Mehmet-Emre-Dogan/smartHome/APP/sourceCode/stratchBackend.png

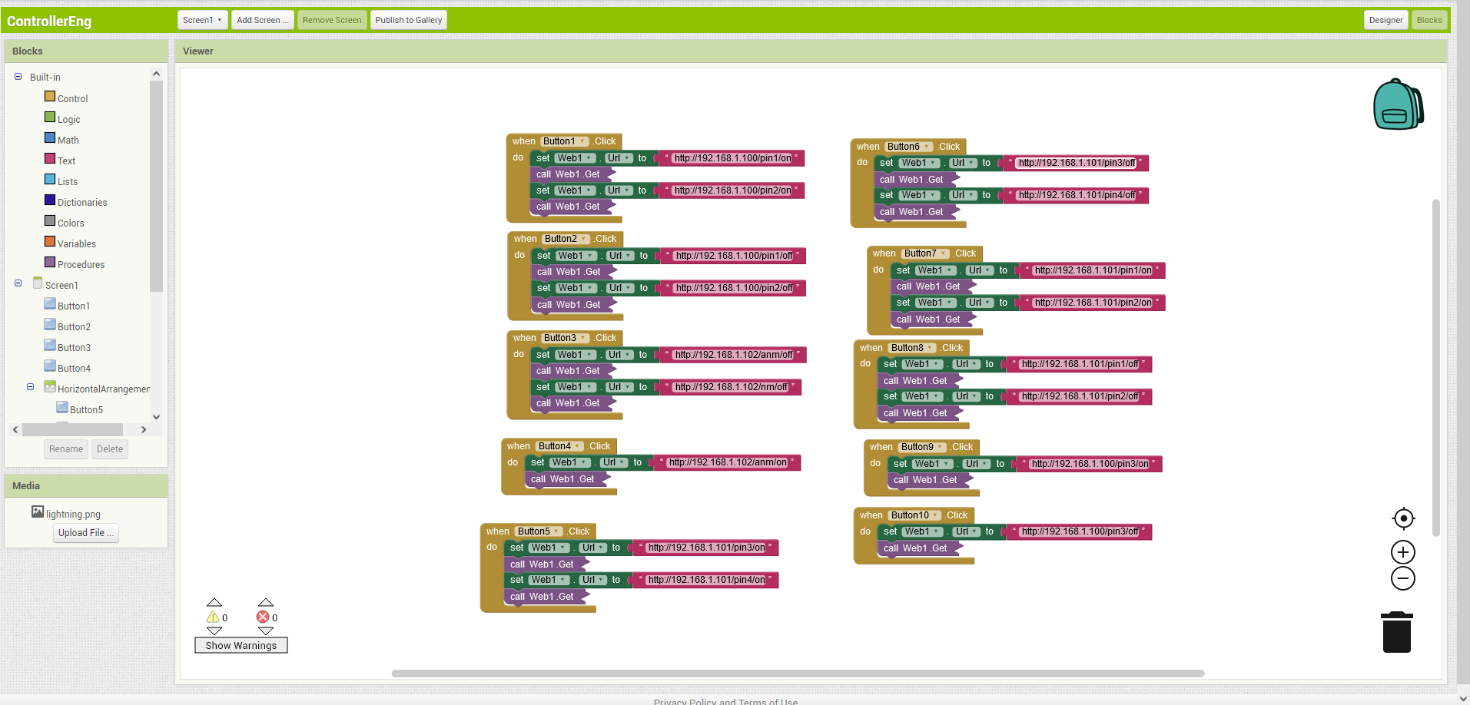
APP/sourceCode/stratchBackend.png
