Mehmet-Emre-Dogan/smartHome/APP/sourceCode/stratchFrontend.png

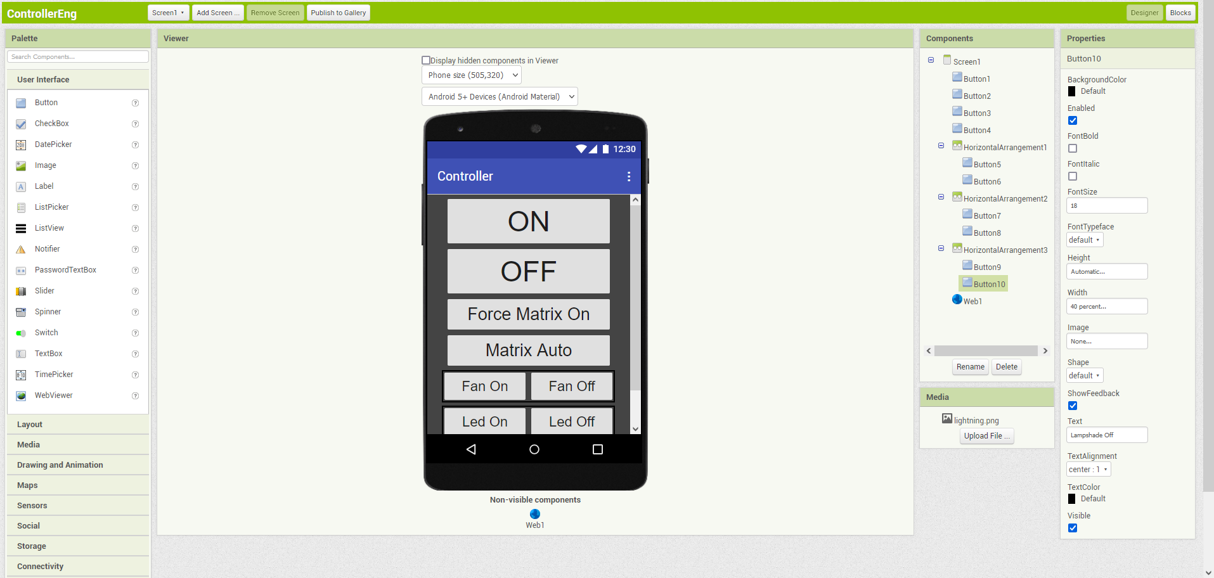
APP/sourceCode/stratchFrontend.png
