Mehmet-Emre-Dogan/smartHome/AUTOMATION/mobile/off/sourceCode/stratchBackendOff.png

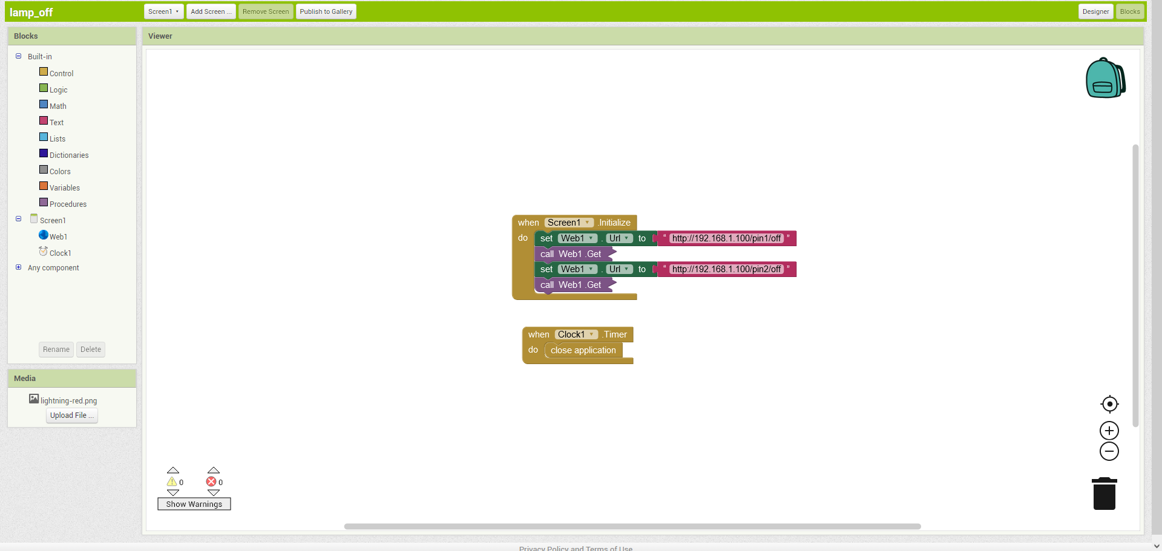
AUTOMATION/mobile/off/sourceCode/stratchBackendOff.png
