Mehmet-Emre-Dogan/smartHome/AUTOMATION/mobile/off/sourceCode/stratchFrontendOff.png

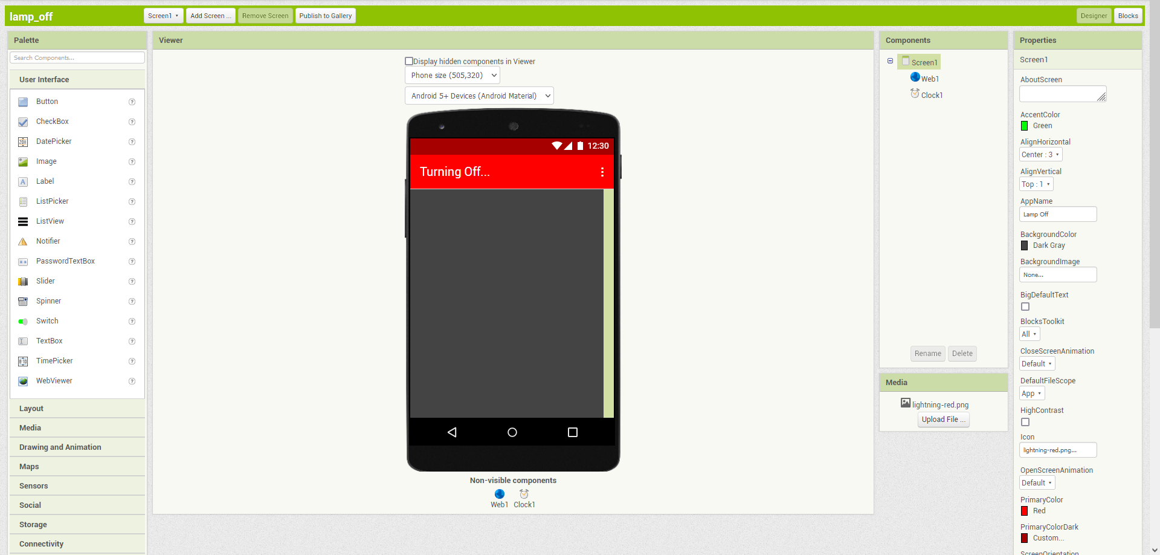
AUTOMATION/mobile/off/sourceCode/stratchFrontendOff.png
