Mehmet-Emre-Dogan/smartHome/(commit log)

2022-02-19 added schematic
2022-02-21 added powerbox code
2022-02-21 fixed bug in schematic
    The vcc and JD_VCC of the relay module must be seperated. VCC must go to 3.3V while JD-VCC must go 5V.
2022-02-25 feature update
    Now after command run (request on and off a device) the code automatically returns to the root page to avoid accidental on-off on refresh
    [customSonoff.ino, lampController.ino]
